adamjvr/AVR-KiCAD-Lib/(commit log)

2018-05-21 First Commit
    Just commit the creation of KiCAD project and new format for component
    libary metadat going forward.
2018-05-21 Resistor Symbol
    Resistor Symbol added to Resistor Library Template
2018-05-31 Additional libraries
    Additional Libraries added. _Value_ field added to each component for
    displaying actual value since KiCAD foces the default Value to be the
    component's name.
2018-11-21 AVR-Method
    Modified library templates to be within the AVR-Method KiCAD library standard. More on the standard here https://github.com/adamjvr/AVR-method
2018-12-02 Phoenix Contact 1017511
    Phoenix Contact lever springcage terminal block added, part number 1017511 (MFR)
2018-12-03 Footprints
    Imported footprints for standard sized SMD resistors and capacitors from my old libraries. Added a footprint for Vicor DCM series regulators, the 38mm long versions.
2018-12-03 Capacitor Footprints
    Added Capacitor footprints for radia capacitors, and two SMT capacitors. Also MCP2308 ADC added.
2019-01-02 Audio Connectors
    Added audio connectors and a generic 2X6 2.54mm header since KiCAD built in offerings are not my style.
2019-04-22 Connectors
    More connectors added with 3D component, refer to change compare to see additions.
2019-04-29 Resistors and Caps
    Resistors and caps for audio applications added, view file change log for update details
2019-04-29 More Parts
    Capacitors and DC barrel jack added. Stomp switch reimagined.
2019-04-30 More Parts
    Transistors and Diodes for Big Muff added
2019-05-03 More Parts
    Added more resistors and capactitors as well as JFETs
2019-05-07 files added
    footprint files added
2019-05-08 Capacitors
    Added more capactitors for EQ filtering circuit types
2019-05-09 Resistors
    More resistors added
2019-05-09 enclosure
    added enclosures
2019-05-11 TRS
    TRS connector footprint adjusted
2019-05-23 Resistors
    more resistors and caps added for baxandall EQ
2019-11-30 New Pots and ICs
    New potentiometers that mount to PCB, new Arm M7, new audio codec
2019-12-06 COmponents Added and Adjustments
    Straightened out Diode category, added oscillator category, made more components relating to x0
2019-12-08 Components
    added more oscilaltors caps and resistors
2019-12-11 Additional components
    added mosfets for USB C power control and digital system passives.
2019-12-12 Passives
    More caps resistors and inductors
2020-06-05 RF Modules and more
    Sug 1GHZ precertified modules and caps/resistors from elsewhere
2020-06-08 Wirless MCUs
    In the process of creating symbols and footprints for STM32 wireless products
2020-06-13 STM32 Wireless symbols
    created symbols for STM32 wireless MCUs for 2.4G wirelss applications, footprints coming next.
2020-06-16 Footprint Import
    Footprints from other libraries I work withg imported, recreated footprints and symbols associated with SunLEaf V2 schematic
2020-06-18 Power components
    components for custom designed DCDC regulators added to library
2020-06-18 Connectors and 5V Logic
    Added Grove style connectors SMT style and 5V logic devices
2020-06-18 Power Inductors
    Inductors rated for power and DCDC applications added to the library, DCDC ICs also added.
2020-06-18 More parts
    Caps, resistors and conenctors
2020-06-19 JST
    JST connectors added
2020-06-24 Relays, Caps, ICs
    Added high power relay, IO expander IC, and power caps
2020-07-08 Oscillators and Resistors
    Added cryhstal for SPI uart bridge, and some new resistor values
2020-07-12 Connectors LEDS and REsistors
    Added mroe resistor sizes, JST connectors, and some LEDs.
2020-07-12 PCB
    PCB design progress made, board shape designed and defined, component placement complete, connecotors aligned and spaced absolute. Power plane and gorund plaines defined. Sensor muxing and connectors routed.
2020-08-01 LED Driver parts
    working on LED driver for friend, added parts related to chipset and Arduino Micro with 3D for all.
2020-08-18 Components Added
    Connectors for SP2SD
2021-02-08 STM32 Module
    In Progress development of STM32 RF module footprint and symbol, see delta for specifics.
2021-02-10 ST RF
    ST RF module symbol and footprint completed, as far as I know I am the first person to build this footprint in KiCAD
2021-02-21 Footprint MOdfied
    JST right angle lipo connector adjusted and 3D model added.
2021-02-26 Sensors
    Lots of sensors and signal conditioning components added
2021-02-26 Resistors
    Added 0402 resistors of vairous sizes
2022-01-02 Converted to KiCAD 6.0
    Converted Libraries over to KiCAD 6.0
2023-08-17 WeeWay Modile
    Added footprint and symbol for WeeWay DCDC regulator module from amazon https://www.amazon.com/Weewooday-Regulator-Voltage-Converter-Transformer/dp/B08JZ5FVLC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
2023-08-24 LED Driver
    Added ST LED driver used by JoyStick-Hat project
2023-09-08 Cap and Ferrite
    Added components for pi filter used in one of my designs
2023-09-27 Pololu Regs and LED driver
    added Pololu Regulators and LED driver to the library
2023-10-04 Caps and Resitors
    Added new capacitors and resistors
2023-10-19 More parts added and Designator Change
    More parts added fro RS485 circuit, and changed connector designators.
2023-10-19 Conenctor Designators
    Changed connector designators
2023-10-20 Designator Change
    Changed Designator letter for battery holders
2023-12-24 RPi Holes
    RPi hat holes component modified
2023-12-25 LS7366R
    Encoder counter chip from LSI/CSI, LS7366R
2024-01-31 G5V-1-DC9
    G5V-1-DC9
    RELAY GENERAL PURPOSE SPDT 1A 9V
2024-02-19 PEC11L-4220F-S0015
    PEC11L-4220F-S0015
    Rotary Encoder Mechanical 15 Quadrature (Incremental) Vertical
2024-04-09 Pheonix contact connectors
    Phoenix contact connectors added
2024-04-09 Encoder
    Encoder footprint fixed to prevent edge cut bug
2024-04-27 More Components
    Added more components, RJ45 connector and crystal
2024-05-06 Caps and RCA
    Capactors and Stereo RCA connector added.
2024-05-06 Screw Connector
    Screw connector for phono ground added. Boardshape DXF added to repo.
2024-05-20 Relay
    Relay Symbol tweak
2024-07-12 LeDs
    More LEDs and an IC added.
2024-07-15 Transistors and Connectors
    Transistors and connectors for wheel chair electronics
2024-07-24 New Transistor
    MOSFET for VNH5019 circuit with more thermal efficiency
2024-08-12 Cap Footprints
    Fixed footprints for aluminum SMT capacitors after fabricating PCB and discovering footprints were too small
2024-08-22 More Parts
    Parts related to open source wheel chair electronics
2024-09-03 Footprint holes
    Regulator footprint holes fixed
2024-09-04 20 Pin
    20 pin shrouded header
2024-09-25 ARM Debug Connector
    ARM Debug Connector Pinout corrected
2024-09-26 Connectors
    Added 3D models to connectors
2024-09-30 Shrouded Header
    added 12 pin shrouded header from molex
2024-10-05 New Resistor
    Added new Resistor
2024-10-28 Fuses
    Added new category for fuse holders
2024-11-02 3D
    Corrected filepath for 3D models for variety of footprints. Added another shrouded header connector and TVS diode.
2024-12-04 IO Expander
    IO Expander added, tweaks to throughhole component metadata that broke bom generation.
2024-12-17 Connectors
    More connectors
2025-01-28 Audio Caps
    Added a new capacitor library for caps that are used in audio applications.
2025-05-07 3D Filepath Linux
    Fixed 3D filepaths for a number of footprints, created some new footprints butmostly just correcting 3D filepath issues. This is a flaw in KiCAD's design, 3D files from external libraries have nonstransferrable filepath from OS to OS, going to keep everythign on Linux from now on.
2025-09-04 More Parts
    Added more components related to Accessibilita main drive motor controller project.
2025-09-13 Transistor footprint
    PPAK8 footprint modfied and 3D added. Also licensing added to repository itself.
2025-09-16 Precision Resistors
    Library for precision resistors added.
